seanboltjes/ECE_477/README.md

# Swing Analysis (Team 13)
Swing Analyzer's code repo!
