seanboltjes/ECE_477/Testing/QuaternionVisualization/README.md

## Quaternion Visualization

Used to visualize the quaternions generated by IMUs.

Used Arduino through Platform.io to interface sensor and then used Serial port to send data to Processing which displayed it
