seanboltjes/ECE_477/Testing/QuaternionVisualization/gifs/dead reckoning/position and accel - zero pos Correction.gif

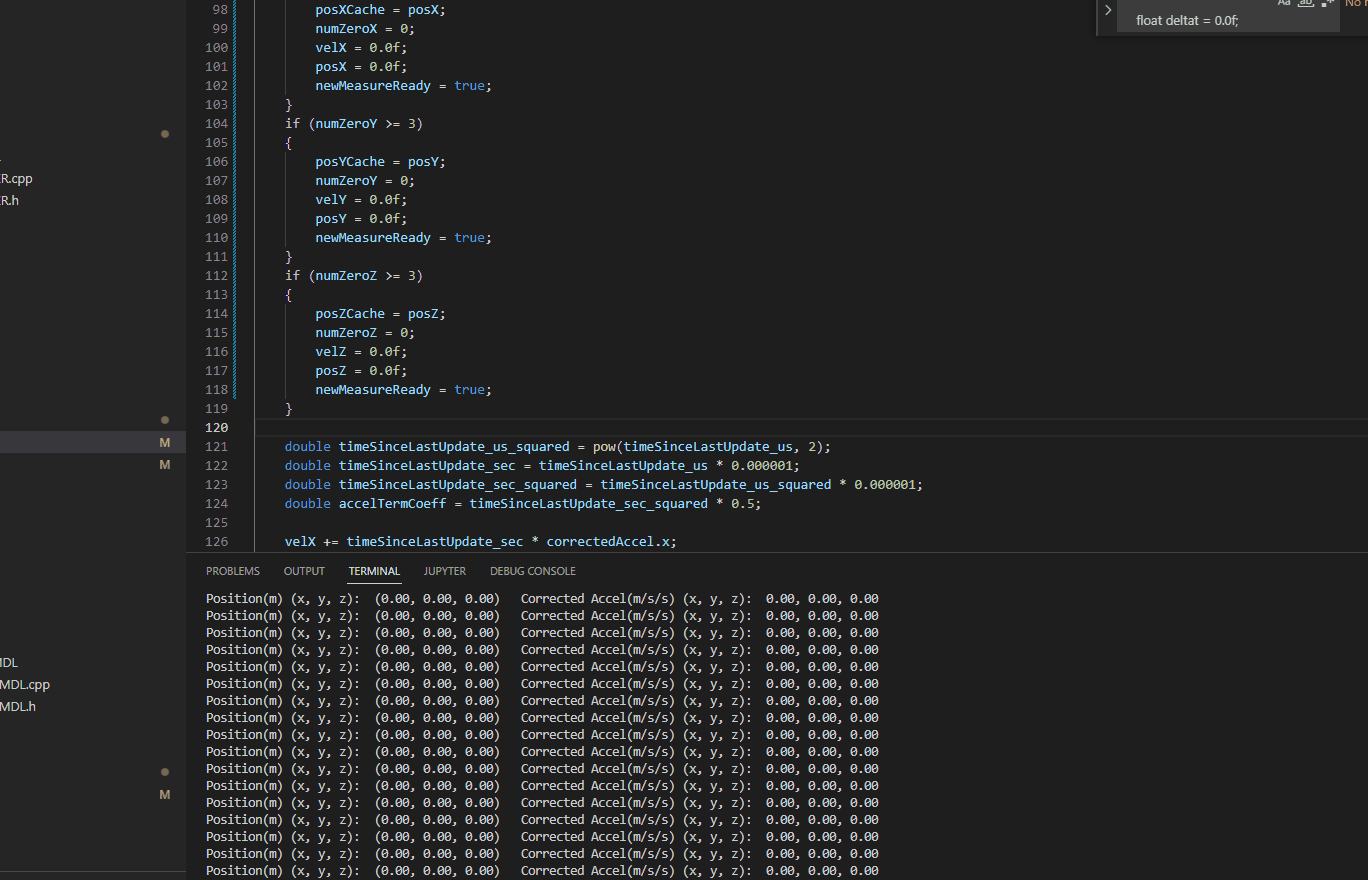
Testing/QuaternionVisualization/gifs/dead reckoning/position and accel - zero pos Correction.gif
