seanboltjes/ECE_477/Testing/QuaternionVisualization/gifs/quaternion/adafruit_fastest ex.gif

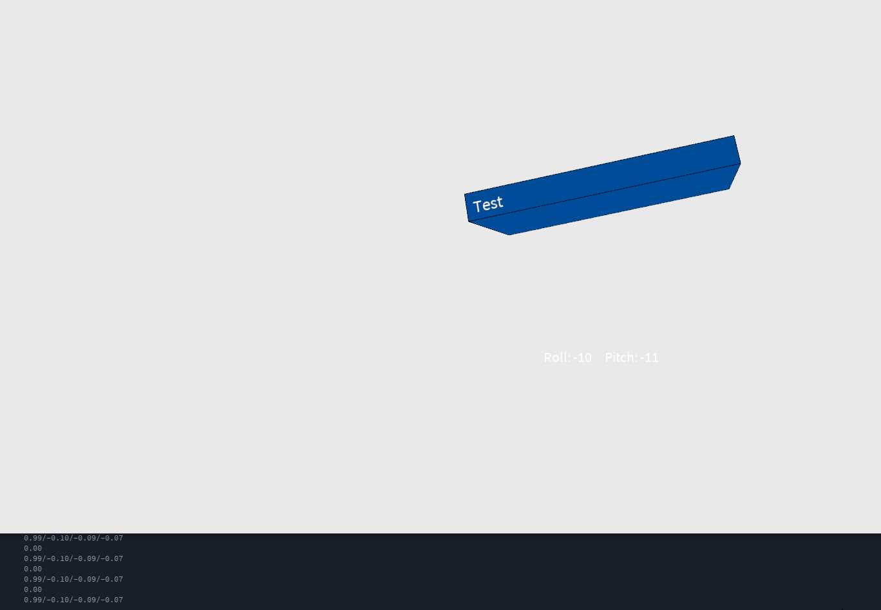
Testing/QuaternionVisualization/gifs/quaternion/adafruit_fastest ex.gif
