seanboltjes/ECE_477/Testing/QuaternionVisualization/gifs/quaternion/adafruit_Madgwick filter.gif

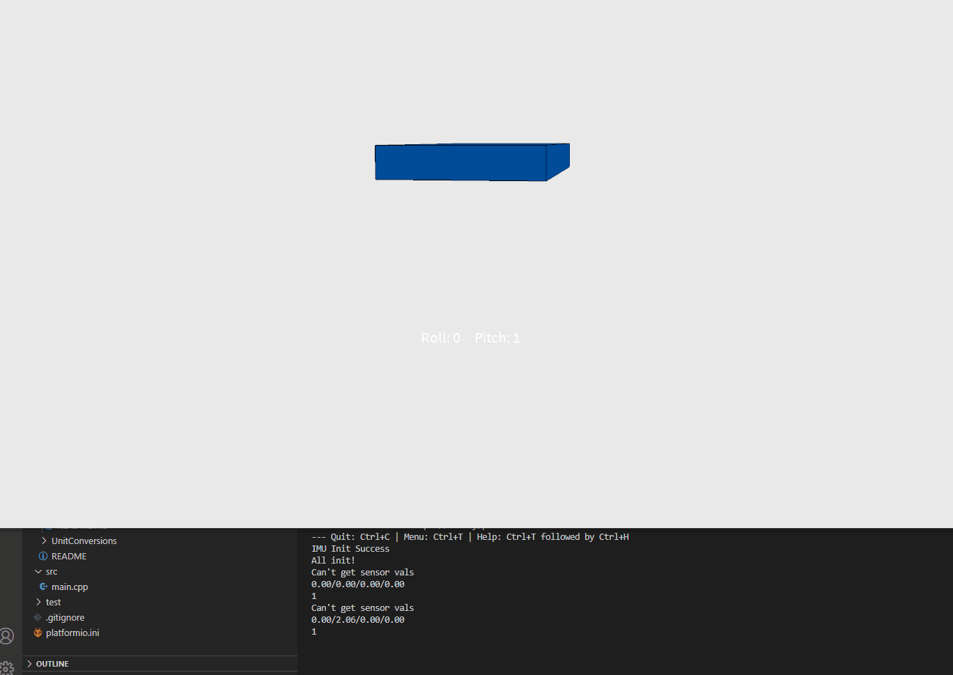
Testing/QuaternionVisualization/gifs/quaternion/adafruit_Madgwick filter.gif
