seanboltjes/ECE_477/Testing/QuaternionVisualization/gifs/quaternion/gyroaccel only.gif

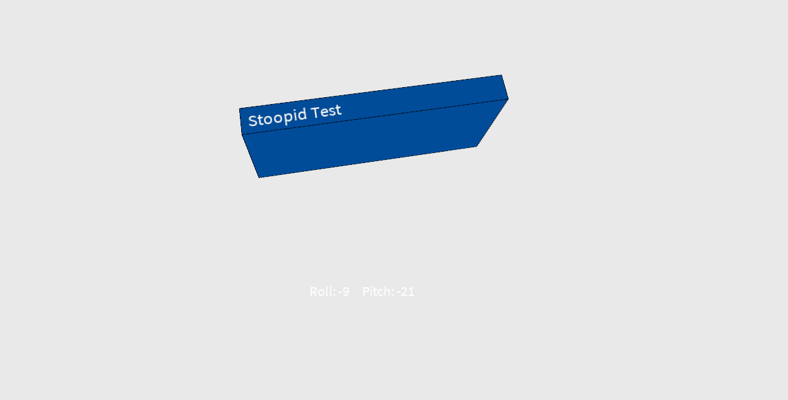
Testing/QuaternionVisualization/gifs/quaternion/gyroaccel only.gif
