seanboltjes/ECE_477/PCB/PCB.kicad_pcb

## KiCad design PCB/PCB.kicad_pcb (2022-10-20)

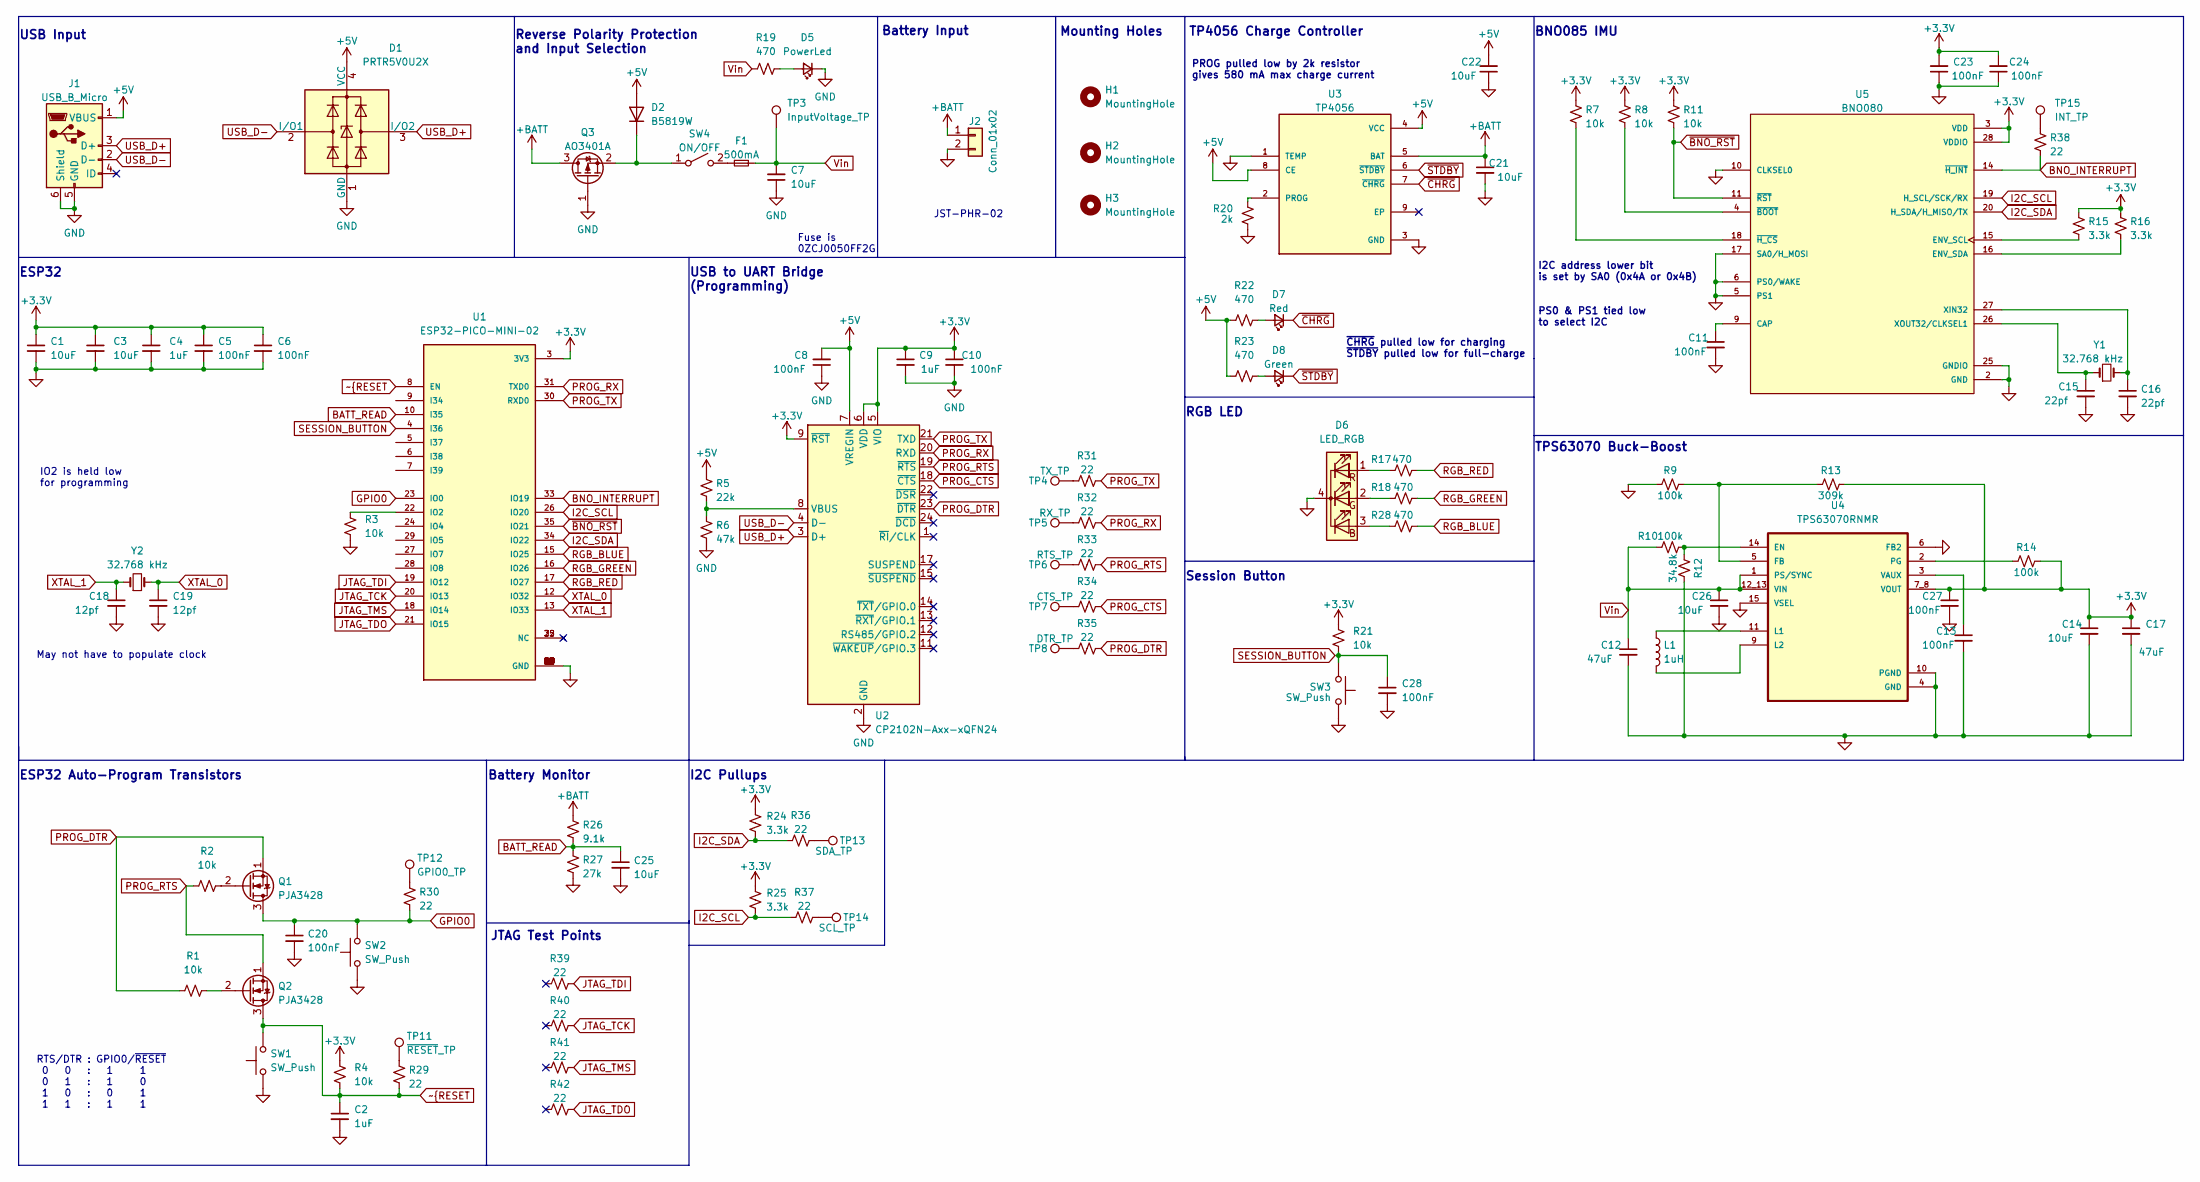
[picture p5: schematic PCB.kicad_sch]

Parts:
C1, C3, C14, C25, C26: 10uF; C_0603_1608Metric
C2, C4, C9: 1uF; C_0603_1608Metric
C5, C6, C8, C10, C11, C13, C20, C23, C24, C27, C28: 100nF; C_0603_1608Metric
C7, C21, C22: 10uF; C_1206_3216Metric
C12: 47uF; C_1206_3216Metric_Pad1.33x1.80mm_HandSolder
C15, C16: 22pf; C_0603_1608Metric
C17: 47uF; C_1206_3216Metric
C18, C19: 12pf; C_0603_1608Metric
D1: PRTR5V0U2X; SOT-143
D2: B5819W; D_1206_3216Metric
D5: PowerLed; LED_0805_2012Metric_Pad1.15x1.40mm_HandSolder
D6: LED_RGB; LED_D5.0mm-4_RGB
D7: Red; LED_0805_2012Metric_Pad1.15x1.40mm_HandSolder
D8: Green; LED_0805_2012Metric_Pad1.15x1.40mm_HandSolder
F1: 500mA; RESC3216X125N
H1, H2, H3: MountingHole; MountingHole_2.2mm_M2_Pad_Via
J1: USB_B_Micro; USB_Micro-B_Molex_47346-0001
J2: Conn_01x02; JST_PHR-2
L1: 1uH; IHLP1212BZER1R0M11
Q1, Q2: PJA3428; SC-82AA_Handsoldering
Q3: AO3401A; SOT-23
R1, R2, R3, R4, R7, R8, R11, R21: 10k; R_0603_1608Metric
R5: 22k; R_0603_1608Metric
R6: 47k; R_0603_1608Metric
R9, R10, R14: 100k; R_0603_1608Metric
R12: 34.8k; R_0603_1608Metric
R13: 309k; R_0603_1608Metric
R15, R16, R24, R25: 3.3k; R_0603_1608Metric
R17, R18, R19, R22, R23, R28: 470; R_0603_1608Metric
R20: 2k; R_0603_1608Metric
R26: 9.1k; R_0603_1608Metric
R27: 27k; R_0603_1608Metric
R29, R30, R31, R32, R33, R34, R35, R36, R37, R38, R39, R40, R41, R42: 22; R_0603_1608Metric
SW1, SW2: SW_Push; SW_Push_1P1T_NO_Vertical_Wuerth_434133025816
SW3: SW_Push; SW_Tactile_SPST_Angled_PTS645Vx58-2LFS
SW4: ON/OFF; CUS-12TB
TP3: InputVoltage_TP; TestPoint_Pad_D1.0mm
TP4: TX_TP; TestPoint_Pad_D1.0mm
TP5: RX_TP; TestPoint_Pad_D1.0mm
TP6: RTS_TP; TestPoint_Pad_D1.0mm
TP7: CTS_TP; TestPoint_Pad_D1.0mm
TP8: DTR_TP; TestPoint_Pad_D1.0mm
TP11: ~{RESET}_TP; TestPoint_Pad_D1.0mm
TP12: GPIO0_TP; TestPoint_Pad_D1.0mm
TP13: SDA_TP; TestPoint_Pad_D1.0mm
TP14: SCL_TP; TestPoint_Pad_D1.0mm
TP15: INT_TP; TestPoint_Pad_D1.0mm
U1: ESP32-PICO-MINI-02; MODULE_ESP32-PICO-MINI-02; PARTREV v1.0
U2: CP2102N-Axx-xQFN24; QFN-24-1EP_4x4mm_P0.5mm_EP2.6x2.6mm
U3: TP4056; SOP127P600X175-9N
U4: TPS63070RNMR; VREG_TPS63070RNMR
U5: BNO080; IC_BNO080; PARTREV 1.6
Y1, Y2: 32.768 kHz; Crystal_SMD_EuroQuartz_EQ161-2Pin_3.2x1.5mm

Connections:
+3.3V: C1.1, C3.1, C4.1, C5.1, C6.1, C9.1, C10.1, C14.1, C17.1, C23.2, C24.2, C27.1, R4.1, R7.1, R8.1, R11.1, R13.1, R14.1, R15.1, R16.1, R21.1, R24.1, R25.1, U1.3 (3V3), U2.5 (VIO), U2.6 (VDD), U2.9 (~RST), U4.7_8 (VOUT), U5.3 (VDD), U5.28 (VDDIO)
+5V: C8.2, C22.2, D1.4 (VCC), D2.2 (A), J1.1 (VBUS), R5.1, R22.1, R23.1, U2.7 (VREGIN), U3.4 (VCC), U3.8 (CE)
+BATT: C21.1, J2.1, Q3.3 (D), R26.1, U3.5 (BAT)
BATT_READ: C25.1, R26.2, R27.1, U1.10 (I35)
BNO_INTERRUPT: R38.1, U1.33 (IO19), U5.14 (~H_INT)
GND: C1.2, C2.2, C3.2, C4.2, C5.2, C6.2, C7.1, C8.1, C9.2, C10.2, C11.2, C12.2, C13.2, C14.2, C15.2, C16.2, C17.2, C18.2, C19.2, C20.2, C21.2, C22.1, C23.1, C24.1, C25.2, C26.2, C27.2, C28.2, D1.1 (GND), D5.1 (K), D6.4 (K), J1.5 (GND), J1.6 (Shield), J2.2, Q3.1 (G), R3.1, R6.2, R9.2, R12.1, R20.1, R27.2, SW1.1, SW2.1, SW3.2, U1.1 (GND), U1.2 (GND), U1.11 (GND), U1.14 (GND), U1.36 (GND), U1.37 (GND), U1.38 (GND), U1.39 (GND), U1.40 (GND), U1.41 (GND), U1.42 (GND), U1.43 (GND), U1.44 (GND), U1.45 (GND), U1.46 (GND), U1.47 (GND), U1.48 (GND), U1.49 (GND), U1.50 (GND), U1.51 (GND), U1.52 (GND), U1.53 (GND), U1.54 (GND), U1.55 (GND), U1.56 (GND), U1.57 (GND), U1.58 (GND), U1.59 (GND), U1.60 (GND), U1.61 (GND), U2.2 (GND), U2.25 (GND), U3.1 (TEMP), U3.3 (GND), U4.4 (GND), U4.6 (FB2), U4.10 (PGND), U4.15 (VSEL), U5.2 (GND), U5.5 (PS1), U5.6 (PS0/WAKE), U5.10 (CLKSEL0), U5.17 (SA0/H_MOSI), U5.25 (GNDIO)
GPIO0: C20.1, Q1.3 (D), R30.2, SW2.2, U1.23 (IO0)
I2C_SCL: R25.2, R37.1, U1.26 (IO20), U5.19 (H_SCL/SCK/RX)
I2C_SDA: R24.2, R36.1, U1.34 (IO22), U5.20 (H_SDA/H_MISO/TX)
JTAG_TCK: R40.2, U1.20 (IO13)
JTAG_TDI: R39.2, U1.19 (IO12)
JTAG_TDO: R42.2, U1.21 (IO15)
JTAG_TMS: R41.2, U1.18 (IO14)
unnamed: C11.1, U5.9 (CAP)
unnamed: C13.1, U4.3 (VAUX)
unnamed: C15.1, U5.26 (XOUT32/CLKSEL1), Y1.1
unnamed: C16.1, U5.27 (XIN32), Y1.2
unnamed: D2.1 (K), Q3.2 (S), SW4.1 (A)
unnamed: D5.2 (A), R19.2
unnamed: D6.1 (RA), R17.1
unnamed: D6.2 (GA), R18.1
unnamed: D6.3 (BA), R28.1
unnamed: D7.2 (A), R22.2
unnamed: D8.2 (A), R23.2
unnamed: F1.1, SW4.2 (B)
unnamed: L1.1, U4.11 (L1)
unnamed: L1.2, U4.9 (L2)
unnamed: Q1.2 (G), R2.2
unnamed: Q2.2 (G), R1.2
unnamed: R3.2, U1.22 (IO2)
unnamed: R5.2, R6.1, U2.8 (VBUS)
unnamed: R7.2, U5.18 (~H_CS)
unnamed: R8.2, U5.4 (~BOOT)
unnamed: R10.2, R12.2, U4.14 (EN)
unnamed: R9.1, R13.2, U4.5 (FB)
unnamed: R14.2, U4.2 (PG)
unnamed: R15.2, U5.15 (ENV_SCL)
unnamed: R16.2, U5.16 (ENV_SDA)
unnamed: R20.2, U3.2 (PROG)
unnamed: R29.1, TP11.1
unnamed: R30.1, TP12.1
unnamed: R31.1, TP4.1
unnamed: R32.1, TP5.1
unnamed: R33.1, TP6.1
unnamed: R34.1, TP7.1
unnamed: R35.1, TP8.1
unnamed: R36.2, TP13.1
unnamed: R37.2, TP14.1
unnamed: R38.2, TP15.1
PROG_CTS: R34.2, U2.18 (~CTS)
PROG_DTR: Q1.1 (S), R1.1, R35.2, U2.23 (~DTR)
PROG_RTS: Q2.1 (S), R2.1, R33.2, U2.19 (~RTS)
PROG_RX: R32.2, U1.31 (TXD0), U2.20 (RXD)
PROG_TX: R31.2, U1.30 (RXD0), U2.21 (TXD)
RGB_BLUE: R28.2, U1.15 (IO25)
RGB_GREEN: R18.2, U1.16 (IO26)
RGB_RED: R17.2, U1.17 (IO27)
SESSION_BUTTON: C28.1, R21.2, SW3.1, U1.4 (I36)
USB_D+: D1.3 (I/O2), J1.3 (D+), U2.3 (D+)
USB_D-: D1.2 (I/O1), J1.2 (D-), U2.4 (D-)
Vin: C7.2, C12.1, C26.1, F1.2, R10.1, R19.1, TP3.1, U4.1 (PS/SYNC), U4.12_13 (VIN)
XTAL_0: C19.1, U1.12 (IO32), Y2.2
XTAL_1: C18.1, U1.13 (IO33), Y2.1
~BNO_RST: R11.2, U1.35 (IO21), U5.11 (~RST)
~CHRG: D7.1 (K), U3.7 (~CHRG)
~RESET: C2.1, Q2.3 (D), R4.2, R29.2, SW1.2, U1.8 (EN)
~STDBY: D8.1 (K), U3.6 (~STDBY)

Notes on the sheet:
RTS/DTR : GPIO0/~{RESET} 0 0 : 1 1 0 1 : 1 0 1 0 : 0 1 1 1 : 1 1
PROG pulled low by 2k resistor gives 580 mA max charge current
May not have to populate clock
BNO085 IMU
USB Input
ESP32
IO2 is held low for programming
Mounting Holes
Reverse Polarity Protection and Input Selection
JST-PHR-02
I2C address lower bit is set by SA0 (0x4A or 0x4B)
Fuse is 0ZCJ0050FF2G
Battery Monitor
USB to UART Bridge (Programming)
JTAG Test Points
I2C Pullups
Session Button
~{CHRG} pulled low for charging ~{STDBY} pulled low for full-charge
ESP32 Auto-Program Transistors
RGB LED
Battery Input
PS0 & PS1 tied low to select I2C
TP4056 Charge Controller
TPS63070 Buck-Boost

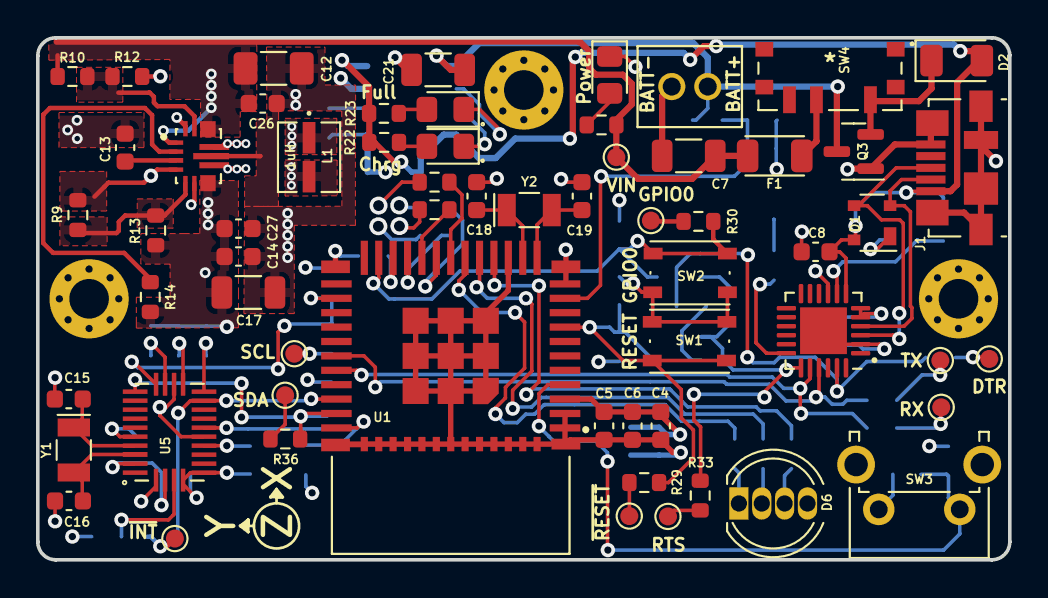
[picture p6: board PCB.kicad_pcb from above]

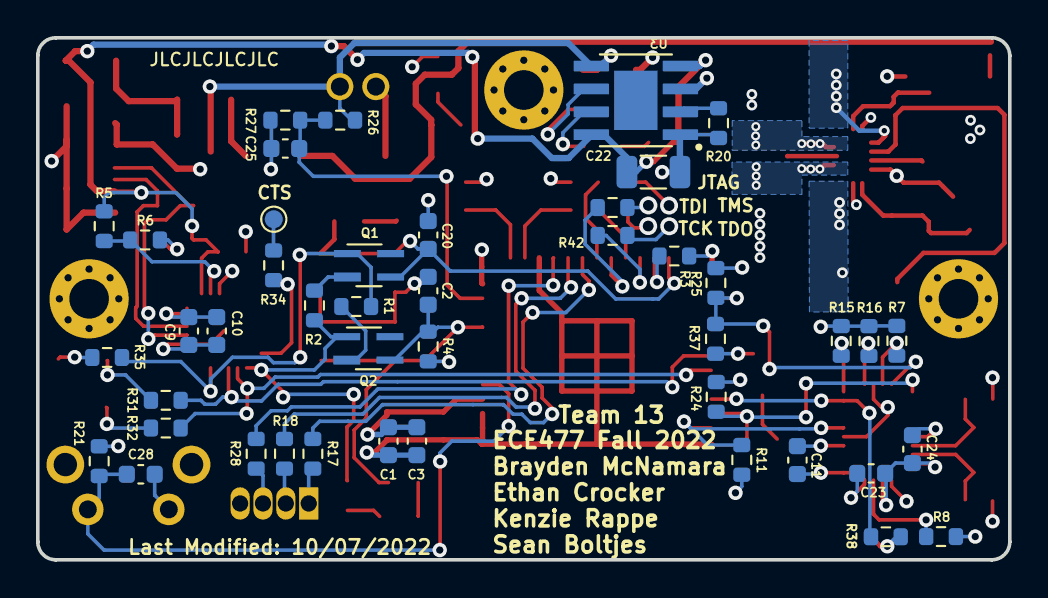
[picture p7: board PCB.kicad_pcb from below]

Board: 4 copper layers, 54.0 x 29.0 mm, 108 parts (44 on the bottom side), 67 nets.
