seanboltjes/ECE_477/(commit log)

2022-09-06 first attempt dead reckoning - huge error margin tho
    [QuaternionVisualization_Processing.pde, main.cpp]
2022-09-16 PCB creation
    [PCB.kicad_pcb, PCB.kicad_sch]
2022-09-16 bno085 schematic done
    [PCB.kicad_sch]
2022-09-20 attempt (x axis is weird)
2022-09-21 buck-boost schematic added
    [PCB.kicad_sch]
2022-09-21 added micro and voltage input schematics
    [PCB.kicad_sch]
2022-09-23 pcb edits
    [PCB.kicad_pcb, PCB.kicad_sch]
2022-09-23 pcb update (transistors)
    [PCB.kicad_pcb, PCB.kicad_sch]
2022-09-26 edge cut improvement and general placements for mechanical design
    [PCB.kicad_pcb]
2022-09-27 progress on tp4056
    [PCB.kicad_sch]
2022-09-27 buck-boost schem vals
    [PCB.kicad_sch]
2022-09-27 bb schem changes
    [PCB.kicad_sch]
2022-09-27 added resistor
    [PCB.kicad_sch]
2022-09-27 more tp4056 progress
    [PCB.kicad_sch]
2022-09-29 most schematics done
    [PCB.kicad_sch]
2022-09-29 more footprints!
    [PCB.kicad_sch]
2022-09-30 huuuuge progress
    [PCB.kicad_pcb, PCB.kicad_sch]
2022-09-30 more placements
    [PCB.kicad_pcb, PCB.kicad_sch]
2022-09-30 placements for everything besides buck/boost
    [PCB.kicad_pcb, PCB.kicad_sch]
2022-09-30 starting routing
    [PCB.kicad_pcb]
2022-09-30 fix power plane issue and more routing
    [PCB.kicad_pcb, PCB.kicad_sch]
2022-10-01 redid battery voltage measure
    [PCB.kicad_pcb, PCB.kicad_sch]
2022-10-01 buck-boost schem
    old schem deleted new one started
    [PCB.kicad_sch]
2022-10-03 more routin'
    [PCB.kicad_pcb, PCB.kicad_sch]
2022-10-03 almost done routing
    [PCB.kicad_pcb]
2022-10-03 main routing finished
    [PCB.kicad_pcb, PCB.kicad_sch]
2022-10-03 component references added
    [PCB.kicad_pcb]
2022-10-03 label btns and tps
    [PCB.kicad_pcb]
2022-10-04 silky touch ups
    [PCB.kicad_pcb]
2022-10-04 final (hopefully) buck-boost schem
2022-10-04 buck-boost delete
    [PCB.kicad_pcb, PCB.kicad_sch]
2022-10-04 buck-boost pcb
    buck-boost added to pcb
    [PCB.kicad_pcb, PCB.kicad_sch]
2022-10-05 updates based on in lab feedback and errors
    [PCB.kicad_pcb, PCB.kicad_sch]
2022-10-05 update the very silky screen
    [PCB.kicad_pcb]
2022-10-06 update power connector and silkscreen
    [PCB.kicad_pcb, PCB.kicad_sch]
2022-10-07 buck-boost pcb changes
    [PCB.kicad_pcb]
2022-10-07 huuuge rerouting and replacement. Added ESD protection resistors
    [PCB.kicad_pcb, PCB.kicad_sch]
2022-10-07 add JTAG support
    [PCB.kicad_pcb, PCB.kicad_sch]
2022-10-07 minor changes
    [PCB.kicad_pcb]
2022-10-11 buck-boost pcb
    layout updated
    [PCB.kicad_pcb, PCB.kicad_sch]
2022-10-12 buck-boost layout
    changed to layout from TI Web bench
    [PCB.kicad_pcb, PCB.kicad_sch]
2022-10-12 buck-boost edits
    [PCB.kicad_pcb, PCB.kicad_sch]
2022-10-12 update pcb with Vin input
    [PCB.kicad_pcb]
2022-10-12 added step models + footprint updates
    [PCB.kicad_pcb]
2022-10-13 buck-boost routing 1
    [PCB.kicad_pcb, PCB.kicad_sch]
2022-10-13 good luck
    [PCB.kicad_pcb]
2022-10-13 update
    routing and planes
    [PCB.kicad_pcb]
2022-10-13 buck/boost more progress
    [PCB.kicad_pcb, PCB.kicad_sch]
2022-10-13 button update
    [PCB.kicad_pcb, PCB.kicad_sch]
2022-10-14 fix silkscreen issues before design review
    [PCB.kicad_pcb]
2022-10-14 added exclusion zones to oscillators
    [PCB.kicad_pcb]
2022-10-17 parts list start
    [PartsList.csv, PartsList.xlsx]
2022-10-18 final changes
    [PCB.kicad_sch]
2022-10-18 schem edits
    [PCB.kicad_sch, PartsList.xlsx]
2022-10-18 parts list update
    [PartsList.xlsx]
2022-10-18 final PCB push
    [PCB-B_Cu.gbr, PCB-B_Mask.gbr, PCB-B_Paste.gbr, PCB-B_Silkscreen.gbr, PCB-Edge_Cuts.gbr, PCB-F_Cu.gbr, PCB-F_Mask.gbr, PCB-F_Paste.gbr]
2022-10-18 better gerbers
    [PCB-B_Cu.gbr, PCB-B_Mask.gbr, PCB-B_Paste.gbr, PCB-B_Silkscreen.gbr, PCB-Edge_Cuts.gbr, PCB-F_Cu.gbr, PCB-F_Mask.gbr, PCB-F_Paste.gbr]
2022-10-19 THIS WAS THE PCB THAT WAS ORDERED
    [PCB-B_Cu.gbr, PCB-B_Mask.gbr, PCB-B_Paste.gbr, PCB-B_Silkscreen.gbr, PCB-Edge_Cuts.gbr, PCB-F_Cu.gbr, PCB-F_Mask.gbr, PCB-F_Paste.gbr]
2022-10-20 Revert "working bluetooth stuff"
    This reverts commit 34ef5b96a591997f13d62c6b10f4f82ffc883183.
    [main.cpp]
